alexlutsenko7/ASpectrum/README.md

# ASpectrum

A ZX Spectrum 128K in an FPGA: an Intel/Altera Cyclone IV E (EP4CE15F23C8) on a QMTECH core board, with the RAM and
ROMs in the board's SDRAM, VGA output, AY sound, a USB keyboard, and a built-in SD card tape loader that plays
unmodified `.tap` / `.tzx` files, saves programs back to the card, and saves / loads `.z80` snapshots.

Status: working on hardware (October 2026).

## Features

- **ZX Spectrum 128K**: T80 Z80 core at the exact 3.5469 MHz, or 28 MHz turbo; 128 KB RAM with 7FFD paging; 128K
  ROM set and DiagROM; AY-3-8912 (JT49); beeper; Kempston joystick; 50 Hz interrupt; memory contention (128K
  timing, memory and I/O cycles; not cycle-exact) and the floating bus, so most timing-critical games and border
  effects run as on the real machine.
- **Memory in SDRAM**: own 112 MHz controller for the W9825G6KH (open-row, CAS latency 2); the CPU is stepped by a
  clock enable and simply waits when the SDRAM is busy. The screen is mirrored in block RAM for the video.
- **Video**: VGA 720x576@50 (576p) or 640x480@60, 2 bits per colour, switchable at run time.
- **USB keyboard** through a CH9350-style UART module, with machine keys: DiagROM, 50/60 Hz, reset.
- **SD card tape loader** on an ESP32 system controller (firmware in C, SPI link to the FPGA):
  - on-screen browser (folders, long names, up to 320 entries), FAT16 / FAT32;
  - plays TAP and TZX (incl. turbo blocks, pure tones, pulse sequences, direct recordings, loops, jumps, calls,
    stop blocks) T-state exact, in turbo (8x) or at normal speed;
  - saves: everything the Spectrum `SAVE`s goes into a `.tap` file on the card;
  - pause, back one block, stop;
  - **snapshots**: F2 saves the whole machine as a `.z80` (version 3, 128K) at any moment; the browser loads
    `.z80` files (versions 1-3, 48K and 128K).
- **Bluetooth audio**: the same ESP32-WROOM-32 (`ASpectrum/esp32/`, Arduino) takes the sound as I2S and sends it to Bluetooth
  speakers / headphones (A2DP), including old PIN-only devices; F3 opens the on-screen Bluetooth menu.
- **Fully constrained timing**: every clock and I/O constrained, timing met at all corners.

## Hardware

| Part | Notes |
|---|---|
| QMTECH Cyclone IV core board | EP4CE15F23C8N, 50 MHz oscillator, W9825G6KH-6 SDRAM (32 MB), W25Q64 configuration flash |
| I/O adapter (own design) | VGA resistor DAC, audio (AY + beeper) to an amplifier, Kempston DB9, USB keyboard module (UART, 3.3 V), 50/60 switch |
| ESP32-WROOM-32 dev board | system controller: SD card, tape loader, Bluetooth audio; wired to U7 (`ASpectrum/esp32/README.md`) |
| microSD | Adafruit 5683 "MicroSD Card BFF" (bare socket, SPI) on the ESP32, 10 uF + 100 nF added |

Pin assignments: `docs/BOARD_PINOUT.md`. Adapter: `docs/QM_ATRIX_ADAPTER.md`.

## Repository layout

| Folder | Contents |
|---|---|
| `ASpectrum/` | **The Spectrum**: Quartus project, `rtl/` (Verilog), `esp32/` (ESP32 firmware: tape loader + Bluetooth), `sim/` (Questa testbenches), `output_files/ASpectrum.jic` (ready-to-program image) |
| `tests/` | hardware test tools: `Test_wires/` (ESP32 <-> FPGA wiring), `ESPLinkTest/` (SPI link), `t80_fmax/` |
| `T80/` | Z80 core (VHDL), from the MiSTer ZX Spectrum core, unchanged (`T80/SOURCE.md`) |
| `DDR_TEST/` | stand-alone SDRAM controller + memory test (the controller used by ASpectrum) |
| `VGA_TEST/` | stand-alone VGA test (colour bars, both video modes) |
| `docs/` | design notes, user documents, data sheets (see below) |

## Building

Tools: Quartus Prime 25.1std Lite (Windows) for the FPGA; Arduino (core esp32 3.3.2, `arduino-cli`) for the ESP32
(libraries: `ASpectrum/esp32/README.md`). The scripts are written for WSL on Windows and call the Windows tools;
paths are at the top of each script.

```
cd ASpectrum
quartus_sh --flow compile ASpectrum              # -> output_files/ASpectrum.sof
quartus_cpf -c ASpectrum.cof                     # -> output_files/ASpectrum.jic (bitstream + ROMs)
arduino-cli compile -b esp32:esp32:esp32 -u -p COM10 esp32       # ESP32 firmware (loader + Bluetooth)
```

The ROM images (`roms48k.hex`) are added to the `.jic` at flash offset 0x100000 and copied into SDRAM at every reset.
A change in `ASpectrum/esp32/` needs only the ESP32 flashed again; a change in `ASpectrum/rtl/` a new compile.

## Programming

Quartus Programmer, JTAG, add `ASpectrum/output_files/ASpectrum.jic`, tick Program/Configure, program, then
power-cycle the board. After that, `.sof` loads over JTAG are enough during development (the ROMs stay in the flash).

## Using it

| Key | Function |
|---|---|
| F12 | tape browser (Enter plays a tape / loads a `.z80` snapshot; first line *[Save to this folder]* starts saving) |
| F2 | save a snapshot: type a name, Enter (`NAME.Z80` in the browser's current folder) |
| F12 while saving | stop saving and close the file |
| Keypad 5 / F11 | pause / continue the tape |
| Keypad - | back one block |
| F7 | stop the tape |
| F5 | memory contention and floating bus on (default) / off |
| F6 | tape speed: turbo (default) / normal |
| F8 | 60 / 50 Hz video (starts at 640x480@60; border effects line up only at 50 Hz) |
| Page Up / Page Down | browser open: page through the list; closed: move the 50 Hz frame interrupt 1/8 line to line up border effects (default 24.1, set for Aquaplane) |
| F1 held at start | DiagROM instead of the 128K ROM |
| Ctrl+Alt+Del | reset the Spectrum |
| KEY0 (board) | reset everything |

Loading: `LOAD ""` (or *Tape Loader* in the 128K menu), F12, choose the file, Enter.
Saving: F12, *[Save to this folder]*, type a name, Enter, then `SAVE` on the Spectrum as often as you like; F12 ends.
Snapshot: F2 at any moment, type a name, Enter; load it later from the F12 browser.
SD card: FAT32 or FAT16 (not exFAT).

The complete key list with step-by-step usage is in `docs/ASpectrum_Keys.docx`.

## Testing

```
bash ASpectrum/esp32/test/run_host_test.sh       # PC: FAT reading/writing, every TAP/TZX signal vs a Python reference, saving, .z80
bash ASpectrum/sim/run_esp_link_sim.sh           # RTL: loader hardware driven over the SPI link by an ESP32 model
bash ASpectrum/sim/run_sim.sh                    # RTL: whole machine boots the 128K ROM
bash ASpectrum/sim/run_snap_sim.sh               # RTL: snapshot freeze / restore with the real T80
bash ASpectrum/sim/run_cont_sim.sh               # RTL: memory contention (NOPs per line in contended RAM: 57 / 41)
bash ASpectrum/sim/run_float_sim.sh              # RTL: floating bus (IN A,(FF) against Fuse's 128K rule)
bash ASpectrum/sim/run_floatgame_sim.sh          # RTL: a .z80 game's floating-bus sync vs Fuse (default Sidewize)
```

The PC tests need a Windows gcc (w64devkit); the simulations need Questa (Intel FPGA Starter Edition).

## Documentation

| Document | Contents |
|---|---|
| `docs/ASpectrum_Architecture.docx` | architecture of the whole machine: block diagram, clocks, memory, video, tape loader, pins, timing |
| `docs/ASpectrum_Keys.docx` | all keys and usage cases |
| `docs/ASpectrum_FKeys.docx` | short sheet of the F keys |
| `docs/SD_TAPE_LOADER.md` | SD tape loader: design, registers, firmware, saving, snapshots |
| `docs/SDRAM_CONTROLLER.md`, `docs/SDRAM_TUTORIAL.md` | the SDRAM controller in detail, and an SDRAM tutorial |
| `docs/T80_CEN_ANALYSIS.md` | running the T80 from a clock enable at 112 MHz |
| `docs/BOARD_PINOUT.md`, `docs/QM_ATRIX_ADAPTER.md` | board headers and the I/O adapter |
| `docs/KNOWN_ISSUES.md` | open issues and limitations |
| `docs/PLAN.md` | design decisions and development log |

## Licences

The project's own files are under the MIT licence (`LICENSE`). Third-party parts keep their own licences:

| Part | Licence |
|---|---|
| `T80/` (Z80 core, Daniel Wallner; Sorgelig) | BSD-style, see the file headers |
| `ASpectrum/rtl/jt49/` (AY-3-8910 core, Jose Tejada) | **GPL-3**: a bitstream that includes it is a GPL-3 work |
| `ASpectrum/esp32/` uses ESP32-A2DP (Phil Schatzmann) | Apache-2.0 (library, not included) |
| ROM images in `ASpectrum/roms48k.hex` and `ASpectrum/sim/roms.mem` | ZX Spectrum 128 ROMs (c) Amstrad, distributed for emulator use with permission, copyright messages unchanged; DiagROM by its authors |
