alexlutsenko7/ASpectrum/docs/ASpectrum_FKeys.docx

# ASpectrum — F keys

Oct 9, 2026 · @Alex

## Overview

Three F keys are new or changed in the 9 October build: F2 saves a snapshot of the whole machine as a .z80 file, and F8 now starts from 640x480@60, and F5 switches memory contention and the floating bus. Snapshots load from the F12 browser. All F keys are on the USB keyboard. 13 October: F3 opens the Bluetooth audio menu (headphones and speakers through the ESP32 board; see ASpectrum_Keys.docx).

Key | What it does | Status
F1 | Held while the Spectrum starts: DiagROM instead of the 128K ROM | unchanged
F2 | Save a snapshot (NAME.Z80) to the SD card | new
F3 | Bluetooth audio menu (ESP32 board): scan, connect, PIN, volume; F3 / Esc closes | new (13 Oct)
F4 | not used
F5 | Memory contention and floating bus on (default) / off | new
F6 | Tape speed for loading and saving: turbo (default) / normal | unchanged
F7 | Stop the tape (also keypad *) | unchanged
F8 | Swap video between 60 Hz (640x480) and 50 Hz (720x576) | changed: always starts at 60 Hz
F9 / F10 | Browser: move up / down | unchanged
F11 | Pause / continue the tape; in the browser: play / load / open | load now includes .z80
F12 | Open / close the SD card browser; stop tape recording | browser now lists .z80 files
Page Up / Page Down | Browser closed: move the 50 Hz frame interrupt 1/8 line (border effects); browser open: page through the list | new

Ctrl+Alt+Del resets the Spectrum and KEY0 on the board resets everything, as before. Confirmed on the hardware: the 60 Hz start, F8, contention and the 50 Hz border alignment (Aquaplane), the floating bus (Sidewize) and snapshots (F2 save, F12 load).

## F2: snapshots

F2 saves the whole machine at any moment: memory, processor, sound chip and border. Loading the file later continues the program from exactly that moment, for example a game at level 5.

### Saving

1. Press F2 at the moment you want to keep. The Spectrum stops at once, the sound goes quiet, and the screen asks for a name.
2. Type a name: up to 8 letters, digits, - or _. There is no suggested name. Backspace deletes a character.
3. Press Enter. The file NAME.Z80 is written in under a second.
4. The Spectrum runs on exactly where it stopped. The bottom row shows Saved NAME.Z80 for 4 seconds.

Esc instead of Enter saves nothing and the Spectrum runs on. A name that already exists is refused ("Already exists: another name").

Where the file goes: into the folder the F12 browser was last in, which is the top folder after power-up. To save into another folder, open the browser with F12, go into that folder, then press F2 there; the browser closes after saving.

### Loading

1. Press F12. The browser lists .z80 files together with .tap and .tzx files.
2. Choose the .z80 file and press Enter (or F11). No LOAD "" is needed: the program continues from the saved moment.

Loading stops a tape that is playing. A file that is not a usable .z80 changes nothing and shows "Not a usable .z80".

### What is in a snapshot

Saved | Not saved
All 128 KB of RAM (8 pages, compressed) | The position inside the video frame (after a load, the next 50 Hz interrupt comes at a different point; harmless for nearly all programs)
Every CPU register, incl. the alternate set, IFF1/IFF2, IM, R | The beeper and MIC level
Port 7FFD (paging, screen, ROM), border colour | A tape position (load the tape again if the program needs more of it)
All 16 AY registers and the selected AY register

- Format: .z80 version 3, "128K" hardware, compatible with emulators such as Fuse and ZEsarUX.
- Loads: .z80 versions 1, 2 and 3, 48K and 128K, so snapshots from emulators work too. 48K snapshots run in 48K mode (48 BASIC ROM, paging locked), as on a real 128. +2, +2A, +3 and Pentagon files load as 128K without their extras.
- Does nothing: while the tape recorder is recording (press F12 to stop recording first), and while the Spectrum is not running (ROMs loading after a reset).
- A playing tape pauses with the Spectrum during the save and continues afterwards.

## F5: memory contention and floating bus

F5 switches memory contention and the floating bus on (default) or off; the bottom row shows Contention: on or off for 4 seconds. Contention is the slowing of the processor while the screen is drawn, as on a real Spectrum; timing-critical games and border effects need it.

- Emulated for memory and port accesses (128K timing), together with the floating bus (reading port FF returns the byte being drawn, as on a real 128K). Not emulated: the extra internal T-states some instructions contend, and ULA snow.
- Never active in turbo. Back to on after KEY0 or power-up.

## Page Up / Page Down: border effects

With the browser closed, Page Up / Page Down move the 50 Hz frame interrupt 1/8 line earlier / later, so border effects line up with the picture. Page Down moves a border stripe down. The bottom row shows Frame INT: 24.1 (line.eighth) for 4 seconds.

- The default 24.1 was measured with Aquaplane's horizon stripe and confirmed on the hardware. It goes back to 24.1 after KEY0 or power-up.
- Only in the 50 Hz mode: at 60 Hz the picture is not locked to the Spectrum frame.
- With the browser open, Page Up / Page Down page through the file list instead.

## F8: video mode

The machine now always powers up in 640x480 at 60 Hz, a mode every VGA monitor accepts. F8 is the only way to change the mode; the 50/60 switch on the adapter is no longer read.

Mode | Resolution | Pixel clock | When
60 Hz | 640x480 (VGA) | 25.000 MHz | power-up default
50 Hz | 720x576 (576p) | 27.000 MHz | after one F8 press; not accepted by every monitor

- Each press swaps the mode. If the picture disappears after F8, press F8 again to get it back.
- The choice is kept across Ctrl+Alt+Del and KEY0 resets; only switching the power off returns to 60 Hz.
- In the 60 Hz mode the Spectrum still gets its interrupts at the 128K rate (one every 70,908 T-states), so programs run at their normal speed.

## Other F keys

These work as before. Every browser action also has a keypad key, so keyboards without F9 to F12 work too.

Key | Browser closed | Browser open
F1 (held while the Spectrum starts) | DiagROM instead of the 128K ROM: hold F1, then power on, press KEY0 or Ctrl+Alt+Del | -
F6 | Tape speed for loading and saving: turbo (default) / normal; "Speed: ..." shows for 2 s | same
F7 (keypad *) | Stop the tape; while recording: stop recording | same
F9 / F10 (keypad 8 / 2, Up / Down) | (Up / Down go to the Spectrum) | Move the selection
F11 (keypad 5 when closed) | Pause / continue the tape | Play the tape / load the .z80 / open the folder
F12 (keypad /, NumLock) | Open the browser; while recording: stop recording | Close the browser

Good to know

- The browser shows up to 350 entries per folder (it was 400; the snapshot code needed the room). Long names show their first 27 characters.
- Page Up / Page Down (also Left / Right, keypad 4 / 6) move one page of 20 lines in the browser; held, they repeat.
- While the browser or a name prompt is on screen, the Spectrum sees no keys. The screen stays until you let go of Enter or Esc, so the Spectrum never sees them.
- SD card: FAT32 or FAT16, not exFAT.
