alexlutsenko7/ASpectrum/ASpectrum/esp32/esp32.ino

// esp32.ino - the ASpectrum system controller on the ESP32: SD tape loader + Bluetooth audio.
//
// Board : ESP32-WROOM-32 dev board (CP2102, Type-C). Arduino core esp32 3.3.x,
//         board "ESP32 Dev Module". Needs Classic BT (original ESP32 only).
// Lib   : ESP32-A2DP by Phil Schatzmann, v1.8.11; AAudioLinkFix (libraries/, copy it into the
//         sketchbook's libraries folder).
//
// SD tape loader (src/): owns the SD card (VSPI) and runs the browser, TAP/TZX playback,
// recording, .z80 load/save and the F3 menu as a task, driving the FPGA's loader hardware over
// the SPI link (src/esp_hw.cpp, rtl/esp_link.v). It starts when the FPGA answers with the
// ASpectrum core ID.
//
// Bluetooth audio: an A2DP source (like a phone) that sends 44.1 kHz stereo to a BT
// speaker/headphones. Audio comes from the FPGA over I2S (the ESP32 is the I2S
// master: BCLK GPIO26, LRCK GPIO25 out, DATA GPIO22 in; rtl/bt_i2s.v),
// or from a built-in test tone ("src tone").
//
// Pairing: SSP devices (BT 2.1+, almost all) are accepted without a code. Legacy
// devices ask for a PIN: by default the common codes 0000, 1234, 8888, 1111 are
// tried in turn (one per connection attempt), or a fixed one is set with "pin".
//
// Control: line commands at 115200 baud on UART2 (RX GPIO16, TX GPIO17), which the
// FPGA's UART connects to the loader's F3 menu (src/bt.cpp), and on USB (Serial) for
// debugging; both take the same commands.
// Replies go to the port the command came from and start with "OK" or "ERR";
// unsolicited events go to both ports and start with "EV". "help" lists them.
// Input lines may end in CR, LF or CR+LF; every output line ends in CR+LF.

#include <AAudioLinkFix.h>   // links with -Wl,--wrap=bta_av_co_audio_set_codec
#include <BluetoothA2DPSource.h>
#include <Preferences.h>
#include <driver/gpio.h>
#include <driver/i2s_std.h>
#include <math.h>
#include "src/loader.h"

// ---------------------------------------------------------------- ESP-IDF 5.5 fix
// When the speaker opens the A2DP stream itself (Bose headphones reconnect to
// their last source by themselves, or answer our connect with their own) and
// configures it with the standard SBC setup, Bluedroid never asks for the sink's
// capabilities. bta_av_co_audio_set_codec() then fails ("peer supports no codec"),
// btc_a2dp_source_setup_codec() skips the encoder setup, and the first stream
// start divides by the encoder's 0 blocks in SBC_Encoder_Init. That
// configuration is Bluedroid's own default (44.1 kHz, joint stereo, 16 blocks,
// 8 subbands), so report success while a link is open: the encoder and the PCM
// feeding are then set up with it (bitpool range from the peer's set-config).
// The caller ignores *status.
static volatile uint32_t codec_forced;   // times the fix was needed

extern "C" uint8_t __real_bta_av_co_audio_set_codec(const void *feeding, void *status);
extern "C" uint8_t btc_av_is_connected(void);

extern "C" uint8_t __wrap_bta_av_co_audio_set_codec(const void *feeding, void *status) {
  if (__real_bta_av_co_audio_set_codec(feeding, status)) return 1;
  if (!btc_av_is_connected()) return 0;
  codec_forced = codec_forced + 1;
  return 1;
}

static const uint32_t SAMPLE_RATE = 44100;
static const int UART2_RX = 16;
static const int UART2_TX = 17;
static const int I2S_BCLK = 26;
static const int I2S_LRCK = 25;
static const int I2S_DIN = 22;
static const int MAX_DEVS = 16;

static const char *const AUTO_PINS[] = {"0000", "1234", "8888", "1111"};
static const int N_AUTO_PINS = sizeof AUTO_PINS / sizeof AUTO_PINS[0];

Preferences prefs;

// ---------------------------------------------------------------- output

static void event(const char *fmt, ...) {
  char buf[128];
  va_list ap;
  va_start(ap, fmt);
  vsnprintf(buf, sizeof buf, fmt, ap);
  va_end(ap);
  Serial.printf("EV %s\r\n", buf);
  Serial2.printf("EV %s\r\n", buf);
}

static void mac_str(const uint8_t *m, char *out) {
  sprintf(out, "%02x:%02x:%02x:%02x:%02x:%02x", m[0], m[1], m[2], m[3], m[4], m[5]);
}

static bool parse_mac(const char *s, uint8_t *m) {
  unsigned v[6];
  if (strlen(s) != 17 ||
      sscanf(s, "%x:%x:%x:%x:%x:%x", &v[0], &v[1], &v[2], &v[3], &v[4], &v[5]) != 6)
    return false;
  for (int i = 0; i < 6; i++) m[i] = (uint8_t)v[i];
  return true;
}

// ---------------------------------------------------------------- audio source
// get_frames() runs in the BT task; loop() only writes the volatile settings.

static volatile bool src_i2s;         // false = test tone
static volatile bool muted;
static i2s_chan_handle_t i2s_rx;
static volatile uint32_t i2s_underruns;
static volatile int32_t i2s_peak;     // largest |sample| since the last status

static int16_t sine_tab[1024];
static volatile uint32_t phase_inc;   // phase step per sample, 2^32 = one period
static volatile int32_t amp;          // 0..32767
static volatile bool square_wave;
static uint32_t phase;
static uint32_t tone_hz, level_pct, volume;

static void set_tone(uint32_t hz) {
  tone_hz = hz;
  phase_inc = (uint32_t)(((uint64_t)hz << 32) / SAMPLE_RATE);
}

static void set_level(uint32_t pct) {
  level_pct = pct;
  amp = (int32_t)(pct * 32767 / 100);
}

static void tone_frames(Frame *f, int32_t n) {
  uint32_t inc = phase_inc;
  int32_t a = amp;
  bool sq = square_wave;
  for (int32_t i = 0; i < n; i++) {
    int32_t s = 0;
    if (inc) {
      s = sq ? ((phase & 0x80000000u) ? -32767 : 32767) : sine_tab[phase >> 22];
      s = (s * a) >> 15;
      phase += inc;
    }
    f[i].channel1 = f[i].channel2 = (int16_t)s;
  }
}

// I2S and A2DP both run from the ESP32's clocks, so on average the data is there;
// a short wait (at most ~8 ms) covers the DMA buffer granularity, silence beyond.
static void i2s_frames(Frame *f, int32_t n) {
  uint8_t *p = (uint8_t *)f;
  size_t want = (size_t)n * sizeof(Frame), got = 0;
  for (int tries = 0; got < want && tries < 4; tries++) {
    size_t r = 0;
    i2s_channel_read(i2s_rx, p + got, want - got, &r, 2);
    got += r;
  }
  if (got < want) {
    memset(p + got, 0, want - got);
    i2s_underruns = i2s_underruns + 1;
  }
  int32_t pk = i2s_peak;
  for (int32_t i = 0; i < n; i++) {
    int32_t a = abs(f[i].channel1);
    if (a > pk) pk = a;
  }
  i2s_peak = pk;
}

static int32_t get_frames(Frame *f, int32_t n) {
  if (src_i2s) i2s_frames(f, n);
  else tone_frames(f, n);
  if (muted) memset(f, 0, (size_t)n * sizeof(Frame));
  return n;
}

static void i2s_start() {
  i2s_chan_config_t chan = I2S_CHANNEL_DEFAULT_CONFIG(I2S_NUM_0, I2S_ROLE_MASTER);
  chan.dma_desc_num = 8;
  chan.dma_frame_num = 256;           // 8 x 5.8 ms of buffering
  ESP_ERROR_CHECK(i2s_new_channel(&chan, nullptr, &i2s_rx));
  i2s_std_config_t cfg = {
      .clk_cfg = I2S_STD_CLK_DEFAULT_CONFIG(SAMPLE_RATE),
      .slot_cfg = I2S_STD_PHILIPS_SLOT_DEFAULT_CONFIG(I2S_DATA_BIT_WIDTH_16BIT, I2S_SLOT_MODE_STEREO),
      .gpio_cfg = {
          .mclk = I2S_GPIO_UNUSED,
          .bclk = (gpio_num_t)I2S_BCLK,
          .ws = (gpio_num_t)I2S_LRCK,
          .dout = I2S_GPIO_UNUSED,
          .din = (gpio_num_t)I2S_DIN,
          .invert_flags = {false, false, false},
      },
  };
  cfg.clk_cfg.clk_src = I2S_CLK_SRC_APLL;   // exact 44.1 kHz
  ESP_ERROR_CHECK(i2s_channel_init_std_mode(i2s_rx, &cfg));
  gpio_pulldown_en((gpio_num_t)I2S_DIN);    // silence when the FPGA is not connected
  ESP_ERROR_CHECK(i2s_channel_enable(i2s_rx));
}

// ---------------------------------------------------------------- devices found
// on_found() runs in the BT task during discovery; loop() prints new entries.

struct Dev {
  uint8_t mac[6];
  char name[32];
  int rssi;
  bool reported;
};

static Dev devs[MAX_DEVS];
static int ndevs;
static portMUX_TYPE devs_mux = portMUX_INITIALIZER_UNLOCKED;

static char target[40];              // MAC "aa:bb:cc:dd:ee:ff" or exact device name
static volatile bool want_connect;   // connect to target when discovery sees it
static char peer_name[32];

static bool is_target(const char *name, const uint8_t *mac) {
  if (!target[0]) return false;
  uint8_t tm[6];
  if (parse_mac(target, tm)) return memcmp(tm, mac, 6) == 0;
  return name[0] && strcasecmp(target, name) == 0;
}

static bool dev_known(const uint8_t *mac) {
  bool known = false;
  portENTER_CRITICAL(&devs_mux);
  for (int i = 0; i < ndevs; i++)
    if (memcmp(devs[i].mac, mac, 6) == 0) known = true;
  portEXIT_CRITICAL(&devs_mux);
  return known;
}

// Records a device seen by discovery; true = it is the target, connect to it.
// A device without a name in the inquiry result gets one later from the name
// request (or never): it is then reported again.
static bool on_found(const char *name, const uint8_t *mac, int rssi) {
  portENTER_CRITICAL(&devs_mux);
  int i;
  for (i = 0; i < ndevs; i++)
    if (memcmp(devs[i].mac, mac, 6) == 0) break;
  if (i == ndevs && ndevs < MAX_DEVS) {
    ndevs++;
    memcpy(devs[i].mac, mac, 6);
    devs[i].name[0] = 0;
    devs[i].rssi = -129;
    devs[i].reported = false;
  }
  if (i < ndevs) {
    if (name[0] && strcmp(devs[i].name, name) != 0) {
      strlcpy(devs[i].name, name, sizeof devs[i].name);
      devs[i].reported = false;
    }
    if (rssi != -129) devs[i].rssi = rssi;
  }
  portEXIT_CRITICAL(&devs_mux);

  bool hit = want_connect && is_target(name, mac);
  if (hit && name[0]) strlcpy(peer_name, name, sizeof peer_name);
  return hit;
}

// ---------------------------------------------------------------- A2DP source
// Adds to the library: pairing with legacy PIN devices (and events about it),
// discovery of devices that only give their name by name request (BT 2.0, the
// PIN ones), no discovery while connected, and the SBC encoder fix below.

static char pin_fixed[17];           // "" = auto (AUTO_PINS)
static volatile int pin_try;         // index into AUTO_PINS
static volatile bool link_up;

class ZxA2DP : public BluetoothA2DPSource {
 public:
  // set_pin_code() copies with strcpy into a 16-byte array: a 16-digit PIN overflows
  void use_pin(const char *pin) {
    size_t n = strlen(pin);
    if (n > ESP_BT_PIN_CODE_LEN) n = ESP_BT_PIN_CODE_LEN;
    memset(pin_code, 0, sizeof pin_code);
    memcpy(pin_code, pin, n);
    pin_code_len = n;
    pin_type = ESP_BT_PIN_TYPE_VARIABLE;
  }

 protected:
  bool pin_asked = false;

  void app_gap_callback(esp_bt_gap_cb_event_t event_id, esp_bt_gap_cb_param_t *param) override {
    switch (event_id) {
      case ESP_BT_GAP_PIN_REQ_EVT: {
        char pin[17];
        strlcpy(pin, pin_fixed[0] ? pin_fixed : AUTO_PINS[pin_try % N_AUTO_PINS], sizeof pin);
        if (param->pin_req.min_16_digit)          // pad to 16 digits with zeros
          while (strlen(pin) < 16) strcat(pin, "0");
        use_pin(pin);
        pin_asked = true;
        event("pairing pin %s", pin);
        break;                                     // the library replies with pin_code
      }
      case ESP_BT_GAP_CFM_REQ_EVT:
        event("pairing confirm %06u (accepted)", (unsigned)param->cfm_req.num_val);
        break;
      case ESP_BT_GAP_KEY_NOTIF_EVT:
        event("pairing passkey %06u", (unsigned)param->key_notif.passkey);
        break;
      case ESP_BT_GAP_AUTH_CMPL_EVT:
        if (param->auth_cmpl.stat == ESP_BT_STATUS_SUCCESS) {
          event("paired %s", (const char *)param->auth_cmpl.device_name);
        } else {
          event("pairing failed (status %d)", param->auth_cmpl.stat);
          if (pin_asked && !pin_fixed[0]) {
            pin_try = (pin_try + 1) % N_AUTO_PINS;
            event("pairing next try with pin %s", AUTO_PINS[pin_try]);
          }
        }
        pin_asked = false;
        break;
      case ESP_BT_GAP_DISC_STATE_CHANGED_EVT:
        // The library restarts discovery whenever it stops without a find, even
        // while connected; inquiry during streaming costs radio time.
        if (link_up && param->disc_st_chg.state == ESP_BT_GAP_DISCOVERY_STOPPED) {
          discovery_active = false;
          return;
        }
        break;
      default:
        break;
    }
    BluetoothA2DPSource::app_gap_callback(event_id, param);
  }

  void app_a2d_callback(esp_a2d_cb_event_t event_id, esp_a2d_cb_param_t *param) override {
    if (event_id == ESP_A2D_CONNECTION_STATE_EVT) {
      if (param->conn_stat.state == ESP_A2D_CONNECTION_STATE_CONNECTED) {
        link_up = true;
        if (discovery_active) esp_bt_gap_cancel_discovery();
      } else if (param->conn_stat.state == ESP_A2D_CONNECTION_STATE_DISCONNECTED) {
        link_up = false;
      }
    }
    BluetoothA2DPSource::app_a2d_callback(event_id, param);
  }

  // As the library's, but a name may also come as BDNAME (name request result,
  // BT 2.0 devices have no EIR) or not at all (then connect by MAC).
  void filter_inquiry_scan_result(esp_bt_gap_cb_param_t *param) override {
    uint32_t cod = 0;
    bool has_cod = false;
    int rssi = -129;
    uint8_t *eir = nullptr;
    char name[ESP_BT_GAP_MAX_BDNAME_LEN + 1] = "";
    for (int i = 0; i < param->disc_res.num_prop; i++) {
      esp_bt_gap_dev_prop_t *p = param->disc_res.prop + i;
      switch (p->type) {
        case ESP_BT_GAP_DEV_PROP_COD:
          cod = *(uint32_t *)p->val;
          has_cod = true;
          break;
        case ESP_BT_GAP_DEV_PROP_RSSI:
          rssi = *(int8_t *)p->val;
          break;
        case ESP_BT_GAP_DEV_PROP_EIR:
          eir = (uint8_t *)p->val;
          break;
        case ESP_BT_GAP_DEV_PROP_BDNAME: {
          int n = p->len < ESP_BT_GAP_MAX_BDNAME_LEN ? p->len : ESP_BT_GAP_MAX_BDNAME_LEN;
          memcpy(name, p->val, n);
          name[n] = 0;
          break;
        }
        default:
          break;
      }
    }
    if (!name[0] && eir) get_name_from_eir(eir, (uint8_t *)name, nullptr);
    if (has_cod ? !(esp_bt_gap_is_valid_cod(cod) && is_valid_cod_service(cod))
                : !dev_known(param->disc_res.bda))
      return;                                      // not an audio device
    if (!on_found(name, param->disc_res.bda, rssi)) return;

    strlcpy((char *)s_peer_bdname, name, sizeof s_peer_bdname);
    s_a2d_state = APP_AV_STATE_DISCOVERED;
    memcpy(peer_bd_addr, param->disc_res.bda, ESP_BD_ADDR_LEN);
    set_last_connection(peer_bd_addr);
    esp_bt_gap_cancel_discovery();                 // the library connects when it stops
  }
};

ZxA2DP a2dp;

// ---------------------------------------------------------------- status

static const char *conn_name(esp_a2d_connection_state_t s) {
  switch (s) {
    case ESP_A2D_CONNECTION_STATE_DISCONNECTED: return "disconnected";
    case ESP_A2D_CONNECTION_STATE_CONNECTING: return "connecting";
    case ESP_A2D_CONNECTION_STATE_CONNECTED: return "connected";
    case ESP_A2D_CONNECTION_STATE_DISCONNECTING: return "disconnecting";
    default: return "?";
  }
}

static void list_devs(Print &out) {
  Dev copy[MAX_DEVS];
  int n;
  portENTER_CRITICAL(&devs_mux);
  n = ndevs;
  memcpy(copy, devs, sizeof copy);
  portEXIT_CRITICAL(&devs_mux);
  out.printf("OK %d device(s)\r\n", n);
  for (int i = 0; i < n; i++) {
    char m[18];
    mac_str(copy[i].mac, m);
    out.printf("%2d %s %4d %s\r\n", i, m, copy[i].rssi, copy[i].name[0] ? copy[i].name : "(no name)");
  }
}

static void status(Print &out) {
  char m[18];
  mac_str(*a2dp.get_last_peer_address(), m);
  out.printf("OK state=%s peer=%s (%s) discovery=%s\r\n",
             conn_name(a2dp.get_connection_state()), m, peer_name[0] ? peer_name : "-",
             a2dp.is_discovery_active() ? "on" : "off");
  if (pin_fixed[0])
    out.printf("   target=%s autoconnect=%s pin=%s\r\n", target[0] ? target : "-",
               want_connect ? "on" : "off", pin_fixed);
  else
    out.printf("   target=%s autoconnect=%s pin=auto (next %s)\r\n", target[0] ? target : "-",
               want_connect ? "on" : "off", AUTO_PINS[pin_try]);
  out.printf("   src=%s vol=%u mute=%s i2s: peak=%d underruns=%u\r\n", src_i2s ? "i2s" : "tone",
             volume, muted ? "on" : "off", (int)i2s_peak, (unsigned)i2s_underruns);
  out.printf("   tone=%u Hz wave=%s level=%u%% codec-fix=%u\r\n", tone_hz,
             square_wave ? "square" : "sine", level_pct, (unsigned)codec_forced);
  i2s_peak = 0;
}

// ---------------------------------------------------------------- commands

static uint32_t last_kick;   // millis() of the last discovery we started
static bool scan_pending;    // scan once the link is down

static void start_discovery() {
  if (a2dp.is_discovery_active()) return;
  esp_bt_gap_start_discovery(ESP_BT_INQ_MODE_GENERAL_INQUIRY, 10, 0);   // 10 x 1.28 s
  last_kick = millis();
}

static void help(Print &out) {
  out.print(
      "OK commands:\r\n"
      "  status                  connection, target, audio (i2s peak since last status)\r\n"
      "  info                    one line: OK info <state> <scan> <MAC> <vol> <pin> <src> <name>\r\n"
      "  scan                    drop the link, search for speakers (EV found ... lines)\r\n"
      "  list                    devices found so far (index MAC rssi name)\r\n"
      "  connect <n|MAC|name>    pair/connect; remembered as target\r\n"
      "  disconnect              drop the link, stop auto-connect\r\n"
      "  forget                  clear target, stored last peer and its pairing\r\n"
      "  pin auto|<code>         PIN for legacy devices; auto tries 0000 1234 8888 1111\r\n"
      "  src i2s|tone            audio from the FPGA or the test tone\r\n"
      "  vol <0..127>            A2DP volume (also sent to the speaker)\r\n"
      "  mute on|off\r\n"
      "  tone <hz>               test tone, 0 = silence (20..20000)\r\n"
      "  wave sine|square        tone shape (square ~ ZX beeper)\r\n"
      "  level <0..100>          tone amplitude in %\r\n");
}

static void command(char *line, Print &out) {
  char *cmd = strtok(line, " \t");
  if (!cmd) return;
  char *arg = strtok(nullptr, "");
  if (arg) {
    while (*arg == ' ' || *arg == '\t') arg++;
    char *e = arg + strlen(arg);
    while (e > arg && (e[-1] == ' ' || e[-1] == '\t')) *--e = 0;
    if (!*arg) arg = nullptr;
  }

  if (!strcasecmp(cmd, "help") || !strcmp(cmd, "?")) {
    help(out);
  } else if (!strcasecmp(cmd, "status")) {
    status(out);
  } else if (!strcasecmp(cmd, "list")) {
    list_devs(out);
  } else if (!strcasecmp(cmd, "info")) {
    char m[18];
    mac_str(*a2dp.get_last_peer_address(), m);
    out.printf("OK info %s %s %s %u %s %s %s\r\n", conn_name(a2dp.get_connection_state()),
               a2dp.is_discovery_active() || scan_pending ? "scan" : "idle", m, volume,
               pin_fixed[0] ? pin_fixed : "auto", src_i2s ? "i2s" : "tone",
               peer_name[0] ? peer_name : "-");
  } else if (!strcasecmp(cmd, "scan")) {
    portENTER_CRITICAL(&devs_mux);
    ndevs = 0;
    portEXIT_CRITICAL(&devs_mux);
    if (a2dp.get_connection_state() != ESP_A2D_CONNECTION_STATE_DISCONNECTED) {
      want_connect = false;                // looking for another device: drop this one first
      a2dp.disconnect();
      scan_pending = true;
    } else {
      start_discovery();
    }
    out.print("OK scanning\r\n");
  } else if (!strcasecmp(cmd, "connect")) {
    if (!arg) { out.print("ERR connect <n|MAC|name>\r\n"); return; }
    char *end;
    long n = strtol(arg, &end, 10);
    if (*end == 0 && n >= 0) {
      if (n >= ndevs) { out.print("ERR no such device, see list\r\n"); return; }
      mac_str(devs[n].mac, target);
      strlcpy(peer_name, devs[n].name, sizeof peer_name);
    } else {
      strlcpy(target, arg, sizeof target);
    }
    prefs.putString("target", target);
    want_connect = true;
    if (a2dp.get_connection_state() == ESP_A2D_CONNECTION_STATE_CONNECTED) a2dp.disconnect();
    else start_discovery();
    out.printf("OK connecting to %s\r\n", target);
  } else if (!strcasecmp(cmd, "disconnect")) {
    want_connect = false;
    a2dp.disconnect();
    out.print("OK\r\n");
  } else if (!strcasecmp(cmd, "forget")) {
    uint8_t tm[6];
    if (parse_mac(target, tm)) esp_bt_gap_remove_bond_device(tm);
    esp_bt_gap_remove_bond_device(*a2dp.get_last_peer_address());
    want_connect = false;
    target[0] = 0;
    peer_name[0] = 0;
    prefs.remove("target");
    a2dp.clean_last_connection();
    out.print("OK\r\n");
  } else if (!strcasecmp(cmd, "pin")) {
    if (arg && !strcasecmp(arg, "auto")) {
      pin_fixed[0] = 0;
      pin_try = 0;
    } else if (arg && strlen(arg) <= 16) {
      strlcpy(pin_fixed, arg, sizeof pin_fixed);
    } else {
      out.print("ERR pin auto|<1..16 chars>\r\n");
      return;
    }
    prefs.putString("pin", pin_fixed);
    out.print("OK\r\n");
  } else if (!strcasecmp(cmd, "src")) {
    if (arg && !strcasecmp(arg, "i2s")) src_i2s = true;
    else if (arg && !strcasecmp(arg, "tone")) src_i2s = false;
    else { out.print("ERR src i2s|tone\r\n"); return; }
    prefs.putBool("i2s", src_i2s);
    out.print("OK\r\n");
  } else if (!strcasecmp(cmd, "tone")) {
    long hz = arg ? atol(arg) : -1;
    if (hz < 0 || (hz > 0 && hz < 20) || hz > 20000) { out.print("ERR tone <0|20..20000>\r\n"); return; }
    set_tone(hz);
    prefs.putUInt("tone", hz);
    out.print("OK\r\n");
  } else if (!strcasecmp(cmd, "wave")) {
    if (arg && !strcasecmp(arg, "sine")) square_wave = false;
    else if (arg && !strcasecmp(arg, "square")) square_wave = true;
    else { out.print("ERR wave sine|square\r\n"); return; }
    prefs.putBool("square", square_wave);
    out.print("OK\r\n");
  } else if (!strcasecmp(cmd, "level")) {
    long p = arg ? atol(arg) : -1;
    if (p < 0 || p > 100) { out.print("ERR level <0..100>\r\n"); return; }
    set_level(p);
    prefs.putUInt("level", p);
    out.print("OK\r\n");
  } else if (!strcasecmp(cmd, "vol")) {
    long v = arg ? atol(arg) : -1;
    if (v < 0 || v > 127) { out.print("ERR vol <0..127>\r\n"); return; }
    volume = v;
    a2dp.set_volume(v);
    prefs.putUInt("vol", v);
    out.print("OK\r\n");
  } else if (!strcasecmp(cmd, "mute")) {
    if (arg && !strcasecmp(arg, "on")) muted = true;
    else if (arg && !strcasecmp(arg, "off")) muted = false;
    else { out.print("ERR mute on|off\r\n"); return; }
    out.print("OK\r\n");
  } else {
    out.printf("ERR unknown command '%s' (help)\r\n", cmd);
  }
}

// Line assembler per port; CR, LF or CRLF end a line, overlong lines are dropped.
struct LineIn {
  Stream &port;
  char buf[96];
  int len;
  bool overflow;

  void poll() {
    while (port.available()) {
      int c = port.read();
      if (c == '\r' || c == '\n') {
        buf[len] = 0;
        if (overflow) port.print("ERR line too long\r\n");
        else if (len) command(buf, port);
        len = 0;
        overflow = false;
      } else if (c >= 0x20 && c < 0x7f) {
        if (len < (int)sizeof buf - 1) buf[len++] = (char)c;
        else overflow = true;
      }
    }
  }
};

static LineIn usb_in{Serial, {0}, 0, false};
static LineIn uart_in{Serial2, {0}, 0, false};

// ---------------------------------------------------------------- setup / loop

void setup() {
  Serial.begin(115200);
  Serial2.begin(115200, SERIAL_8N1, UART2_RX, UART2_TX);
  gpio_pullup_en((gpio_num_t)UART2_RX);   // idle-high when the FPGA is not connected

  for (int i = 0; i < 1024; i++) sine_tab[i] = (int16_t)lroundf(32767.0f * sinf(i * 2.0f * (float)M_PI / 1024));

  prefs.begin("btaudio", false);
  set_tone(prefs.getUInt("tone", 1000));
  set_level(prefs.getUInt("level", 30));
  square_wave = prefs.getBool("square", false);
  src_i2s = prefs.getBool("i2s", true);
  volume = prefs.getUInt("vol", 64);
  strlcpy(target, prefs.getString("target", "").c_str(), sizeof target);
  strlcpy(pin_fixed, prefs.getString("pin", "").c_str(), sizeof pin_fixed);
  want_connect = target[0] != 0;

  i2s_start();

  a2dp.set_local_name("ASpectrum");
  a2dp.set_auto_reconnect(true);          // reconnect to the last peer stored in NVS
  a2dp.set_data_callback_in_frames(get_frames);
  a2dp.set_volume(volume);
  a2dp.start();

  Serial.print("\r\nASpectrum BT audio. Type 'help'.\r\n");
  status(Serial);
  loader_begin();
}

void loop() {
  loader_poll();
  usb_in.poll();
  uart_in.poll();

  // Report newly found (or newly named) devices.
  for (int i = 0; i < ndevs; i++) {
    if (devs[i].reported) continue;
    Dev d;
    portENTER_CRITICAL(&devs_mux);
    devs[i].reported = true;
    d = devs[i];
    portEXIT_CRITICAL(&devs_mux);
    char m[18];
    mac_str(d.mac, m);
    event("found %d %s %d %s", i, m, d.rssi, d.name[0] ? d.name : "(no name)");
  }

  // Report connection / discovery changes.
  static esp_a2d_connection_state_t last_conn = ESP_A2D_CONNECTION_STATE_DISCONNECTED;
  static bool last_disc = false;
  esp_a2d_connection_state_t conn = a2dp.get_connection_state();
  if (conn != last_conn) {
    last_conn = conn;
    char m[18];
    mac_str(*a2dp.get_last_peer_address(), m);
    event("%s %s %s", conn_name(conn), m, peer_name);
  }
  static uint32_t last_forced = 0;
  if (codec_forced != last_forced) {
    last_forced = codec_forced;
    event("codec set up by the IDF fix (%u)", (unsigned)last_forced);
  }
  bool disc = a2dp.is_discovery_active();
  if (disc != last_disc) {
    last_disc = disc;
    event("discovery %s", disc ? "on" : "off");
  }

  if (scan_pending && conn == ESP_A2D_CONNECTION_STATE_DISCONNECTED) {
    scan_pending = false;
    start_discovery();
  }

  // The library stops searching after a deliberate disconnect and gives up after
  // its reconnect retries; restart discovery if we still have a target to reach.
  // The first 15 s belong to the library's own start-up (10 s wait + reconnect).
  if (want_connect && conn == ESP_A2D_CONNECTION_STATE_DISCONNECTED && !disc &&
      millis() > 15000 && millis() - last_kick > 15000)
    start_discovery();

  delay(10);
}
