alexlutsenko7/ASpectrum/ASpectrum/rtl/sys_pll.v

// sys_pll -- 50 MHz in; c0 = 112 MHz system clock (50 * 56 / 25 = 4 x 28 MHz),
//            c1 = 112 MHz delayed by SD_PHASE_PS, drives the SDRAM clock DDIO,
//            c2 = 56 MHz (50 * 28 / 25), rising edges aligned with c0: SD tape loader
`default_nettype none

module sys_pll #(
    parameter SD_PHASE_PS = "1000"
)(
    input  wire inclk0,
    output wire c0,
    output wire c1,
    output wire c2,
    output wire locked
);

wire [4:0] clk_bus;
assign c0 = clk_bus[0];
assign c1 = clk_bus[1];
assign c2 = clk_bus[2];

altpll altpll_component (
    .areset (1'b0),
    .inclk  ({1'b0, inclk0}),
    .clk    (clk_bus),
    .locked (locked)
);
defparam
    altpll_component.bandwidth_type          = "AUTO",
    altpll_component.clk0_divide_by          = 25,
    altpll_component.clk0_duty_cycle         = 50,
    altpll_component.clk0_multiply_by        = 56,
    altpll_component.clk0_phase_shift        = "0",
    altpll_component.clk1_divide_by          = 25,
    altpll_component.clk1_duty_cycle         = 50,
    altpll_component.clk1_multiply_by        = 56,
    altpll_component.clk1_phase_shift        = SD_PHASE_PS,
    altpll_component.clk2_divide_by          = 25,
    altpll_component.clk2_duty_cycle         = 50,
    altpll_component.clk2_multiply_by        = 28,
    altpll_component.clk2_phase_shift        = "0",
    altpll_component.compensate_clock        = "CLK0",
    altpll_component.inclk0_input_frequency  = 20000,
    altpll_component.intended_device_family  = "Cyclone IV E",
    altpll_component.lpm_hint                = "CBX_MODULE_PREFIX=sys_pll",
    altpll_component.lpm_type                = "altpll",
    altpll_component.operation_mode          = "NORMAL",
    altpll_component.pll_type                = "AUTO",
    altpll_component.port_activeclock        = "PORT_UNUSED",
    altpll_component.port_areset             = "PORT_USED",
    altpll_component.port_clkbad0            = "PORT_UNUSED",
    altpll_component.port_clkbad1            = "PORT_UNUSED",
    altpll_component.port_clkloss            = "PORT_UNUSED",
    altpll_component.port_clkswitch          = "PORT_UNUSED",
    altpll_component.port_configupdate       = "PORT_UNUSED",
    altpll_component.port_fbin               = "PORT_UNUSED",
    altpll_component.port_inclk0             = "PORT_USED",
    altpll_component.port_inclk1             = "PORT_UNUSED",
    altpll_component.port_locked             = "PORT_USED",
    altpll_component.port_pfdena             = "PORT_UNUSED",
    altpll_component.port_phasecounterselect = "PORT_UNUSED",
    altpll_component.port_phasedone          = "PORT_UNUSED",
    altpll_component.port_phasestep          = "PORT_UNUSED",
    altpll_component.port_phaseupdown        = "PORT_UNUSED",
    altpll_component.port_pllena             = "PORT_UNUSED",
    altpll_component.port_scanaclr           = "PORT_UNUSED",
    altpll_component.port_scanclk            = "PORT_UNUSED",
    altpll_component.port_scanclkena         = "PORT_UNUSED",
    altpll_component.port_scandata           = "PORT_UNUSED",
    altpll_component.port_scandataout        = "PORT_UNUSED",
    altpll_component.port_scandone           = "PORT_UNUSED",
    altpll_component.port_scanread           = "PORT_UNUSED",
    altpll_component.port_scanwrite          = "PORT_UNUSED",
    altpll_component.port_clk0               = "PORT_USED",
    altpll_component.port_clk1               = "PORT_USED",
    altpll_component.port_clk2               = "PORT_USED",
    altpll_component.port_clk3               = "PORT_UNUSED",
    altpll_component.port_clk4               = "PORT_UNUSED",
    altpll_component.port_clk5               = "PORT_UNUSED",
    altpll_component.self_reset_on_loss_lock = "OFF",
    altpll_component.width_clock             = 5;

endmodule

`default_nettype wire
