alexlutsenko7/ASpectrum/ASpectrum/rtl/jt49/jt49_div.v

/*  This file is part of JT49.

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
    Author: Jose Tejada Gomez. Twitter: @topapate
    Version: 1.0
    Date: 10-Nov-2018
    
    Based on sqmusic, by the same author
    
    */


module jt49_div #(parameter W=12 )(   
    (* direct_enable *) input cen,
    input           clk, // this is the divided down clock from the core
    input           rst_n,
    input [W-1:0]  period,
    output reg      div
);

reg [W-1:0]count;// = (W)'(0);

wire [W-1:0] one = { {W-1{1'b0}}, 1'b1};

always @(posedge clk, negedge rst_n ) begin
  if( !rst_n) begin
    count <= one;
    div   <= 1'b0;
  end
  else if(cen) begin
    if( count>=period ) begin
        count <= one;
        div   <= ~div;
    end
    else
        /*if( period!={W{1'b0}} )*/ count <=  count + one ;
  end
end

endmodule
